Grahev/esp32_targets/hardware/kicad/node.kicad_sch

## KiCad design hardware/kicad/node.kicad_sch (2026-10-24)

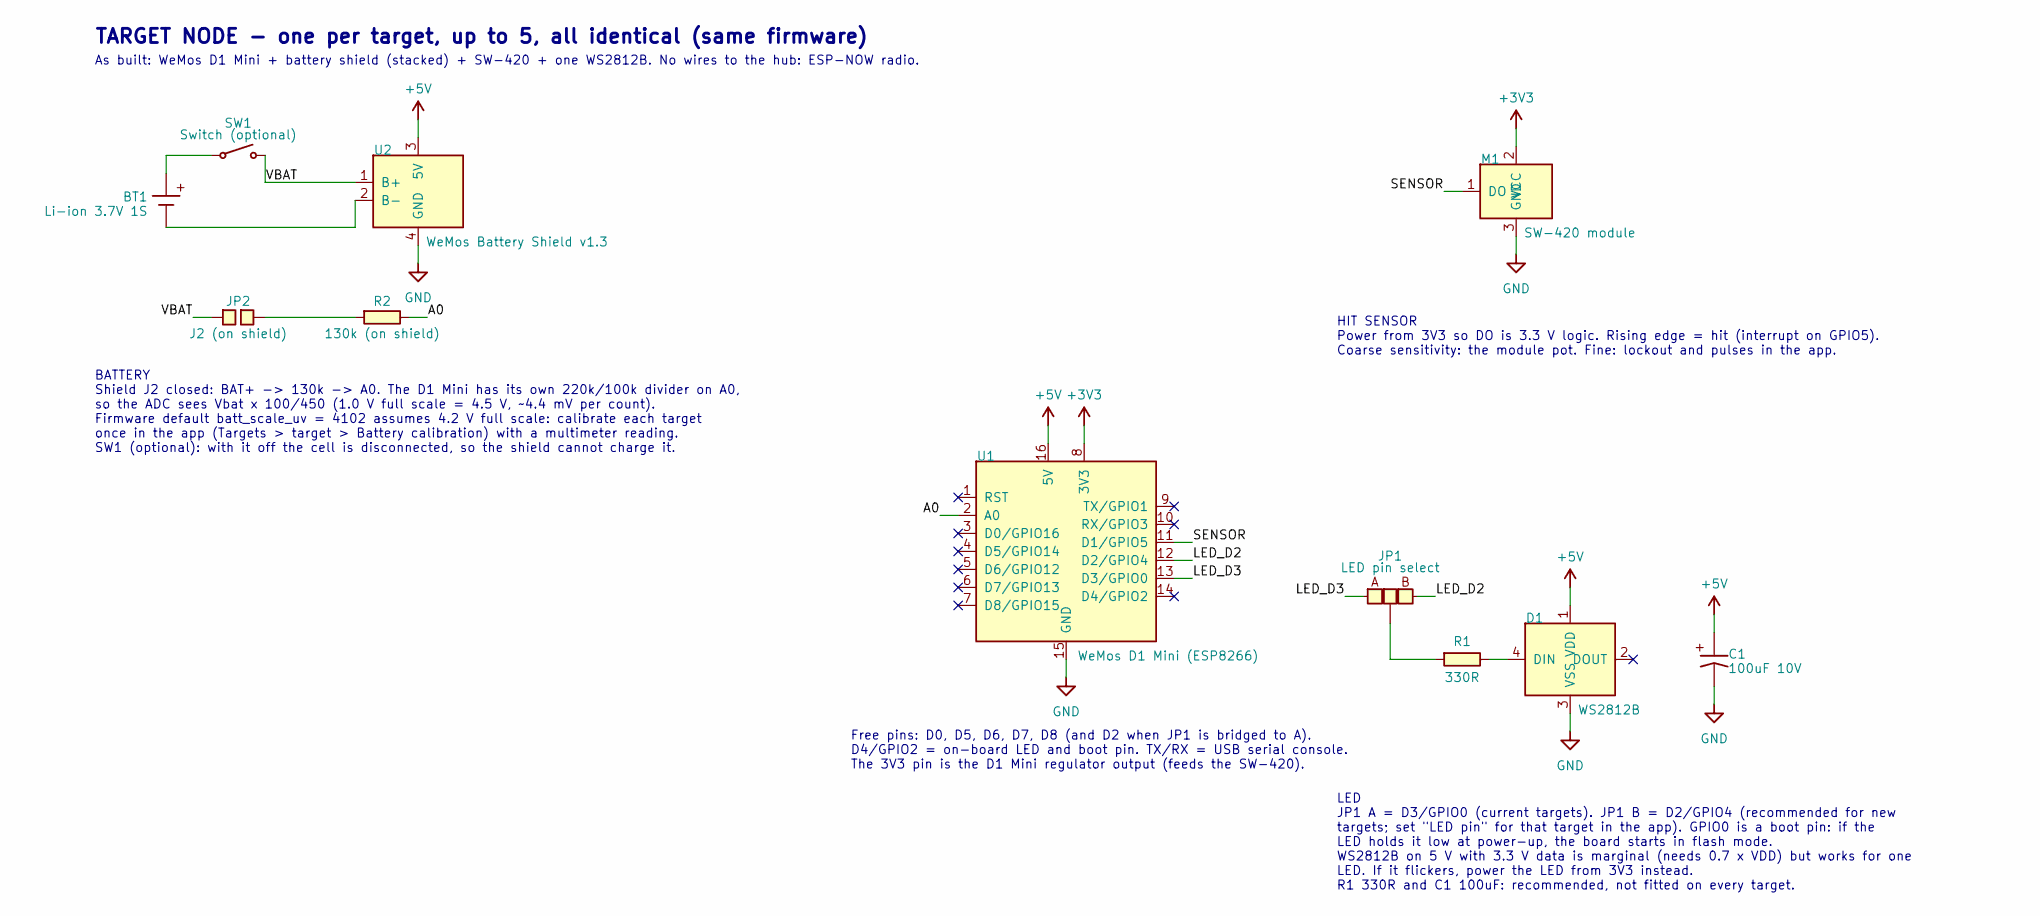
[picture p1: schematic node.kicad_sch]

Parts:
BT1: Li-ion 3.7V 1S
C1: 100uF 10V
D1: WS2812B
JP1: LED pin select
JP2: J2 (on shield)
M1: SW-420 module
R1: 330R
R2: 130k (on shield)
SW1: Switch (optional)
U1: WeMos D1 Mini (ESP8266)
U2: WeMos Battery Shield v1.3

Connections:
+3V3: M1.2 (VCC), U1.8 (3V3)
+5V: C1.1 (+), D1.1 (VDD), U1.16 (5V), U2.3 (5V)
A0: R2.2, U1.2 (A0)
GND: C1.2 (-), D1.3 (VSS), M1.3 (GND), U1.15 (GND), U2.4 (GND)
LED_D2: JP1.3 (B), U1.12 (D2/GPIO4)
LED_D3: JP1.1 (A), U1.13 (D3/GPIO0)
unnamed: BT1.1 (+), SW1.1
unnamed: BT1.2 (-), U2.2 (B-)
unnamed: D1.4 (DIN), R1.2
unnamed: JP1.2 (C), R1.1
unnamed: JP2.2, R2.1
SENSOR: M1.1 (DO), U1.11 (D1/GPIO5)
VBAT: JP2.1, SW1.2, U2.1 (B+)

Notes on the sheet:
TARGET NODE - one per target, up to 5, all identical (same firmware)
As built: WeMos D1 Mini + battery shield (stacked) + SW-420 + one WS2812B. No wires to the hub: ESP-NOW radio.
BATTERY Shield J2 closed: BAT+ -> 130k -> A0. The D1 Mini has its own 220k/100k divider on A0, so the ADC sees Vbat x 100/450 (1.0 V full scale = 4.5 V, ~4.4 mV per count). Firmware default batt_scale_uv = 4102 assumes 4.2 V full scale: calibrate each target once in the app (Targets > target > Batt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
Free pins: D0, D5, D6, D7, D8 (and D2 when JP1 is bridged to A). D4/GPIO2 = on-board LED and boot pin. TX/RX = USB serial console. The 3V3 pin is the D1 Mini regulator output (feeds the SW-420).
HIT SENSOR Power from 3V3 so DO is 3.3 V logic. Rising edge = hit (interrupt on GPIO5). Coarse sensitivity: the module pot. Fine: lockout and pulses in the app.
LED JP1 A = D3/GPIO0 (current targets). JP1 B = D2/GPIO4 (recommended for new targets; set "LED pin" for that target in the app). GPIO0 is a boot pin: if the LED holds it low at power-up, the board starts in flash mode. WS2812B on 5 V with 3.3 V data is marginal (needs 0.7 x VDD) but works for one 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
