Grahev/esp32_targets/(commit log)

2026-01-10 Implement Multi-Node Sensor Support: Protocol update, dynamic hub registration, and automatic node announcement
2026-01-10 Fix Indentation Error in main.py
    [main.py]
2026-01-10 Update Difficulty Curves: Slower respawns, 30s stages, 4s combo timeout
2026-01-30 Add battery monitoring features including percentage and charging status
2026-01-30 Implement node idle behavior: Blue LED indicators and ignore hits when no game is active
2026-10-23 Add CLAUDE.md with project overview and board workflow
    Documents the hub/node ESP-NOW protocol, game flow, and the repo-to-board
    path mapping. Notes that the node is an ESP8266 and fixes the upload
    examples so hub files land at the board root.
2026-10-23 fix: atomic score saves, keep corrupt score files aside (REVIEW #1)
    Scores are written to a .tmp file and renamed over the real file, so a
    power cut can't truncate it. A score file that fails to parse is renamed
    to .corrupt instead of being overwritten by the next save.
    [main.py, storage.py]
2026-10-23 fix: /stop returns nodes to standby then idle (REVIEW #2)
    game_over() takes save=False for aborted games instead of /stop clearing
    hub.game first, which made game_over() a no-op and left nodes Active.
    Adds tools/hub_harness.py to drive the hub's routes on real hardware.
    [hub_harness.py, main.py]
2026-10-23 fix: guard radio listener and game loop, reboot on fatal crash (REVIEW #3)
    - listener drains all pending packets per pass and logs errors instead
    of dying; packet decoding moved to HUB_SYSTEM.handle_packet
    - an exception in tick() aborts the game (nodes to standby) instead of
    silently stopping the game loop task
    - a crash in main() reboots the hub; Ctrl-C still reaches the REPL
    - drops the unreachable 4-field legacy branch and unused Pin import
    [hub_harness.py, main.py]
2026-10-23 fix: reliable multi-node radio protocol and node tracking (REVIEW #4-#10, #18)
    Protocol v2 (hub still accepts v1 packets, so nodes can upgrade one by one):
    - node unicasts to the hub once it knows the hub MAC (ACK + radio retries),
    3 app-level retries, falls back to broadcast (#5)
    - 12-byte little-endian packet with version and sequence number; hub drops
    retried duplicates (#7)
    - hub assigns node IDs by MAC, persisted in nodes.json; nodes store the
    assigned ID via new CMD_SET_ID, no config edits needed (#6)
    Hub:
    - node_registry tracks last_seen; nodes silent for 15 s go offline, are
    removed from the pool and the ESP-NOW peer table, and games are told via
    on_node_lost (#4, #18)
    - c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
    [game_engine.py, hub_harness.py, main.py, node_fake_hit.py, node_registry.py]
2026-10-23 fix: no blocking sleeps in game ticks; Time Attack+ spawn delay and no-repeat (REVIEW #11, #12)
    - The Breach countdown pulses via timed states instead of sleep_ms(100);
    Time Attack+ end no longer sleeps on the event loop (#11)
    - Time Attack+ no longer re-lights the node that was just hit, and waits
    the stage's spawn delay (1.2/0.8/0.5 s) before lighting a new target,
    as the PRD specifies; a single-node setup still gets its node back
    after the delay (#12)
    [game_engine.py]
2026-10-23 fix: The Breach precision bonus no longer compounds (REVIEW #13)
    The 1.2x bonus is applied to the level's points instead of the running
    total. A failed game now ends exactly once.
    Adds tests/sim.py (fake clock + fake hub with N nodes) and
    tests/test_game_modes.py: 14 multi-node scenarios for both modes, e.g.
    10-node spawn fairness, nodes joining/leaving mid-game, spawn delay,
    no-repeat, freeze, bonus compounding.
    [game_engine.py, hub_harness.py]
2026-10-23 fix: time out WebSocket sends and drop stuck clients (REVIEW #14)
    Each send runs under a 2 s timeout; a client whose send fails is removed
    and its socket closed, instead of piling up blocked send tasks. Initial
    state sends are inside the handler's try so a failed client is always
    removed.
    Also: a MEM log line every 60 s (python + IDF heap), new review finding
    #36 (low IDF heap headroom), PC hub tests (tests/test_hub.py with stubbed
    MicroPython modules) and harness scenarios for The Breach, crash
    injection and an on-device HTTP/WebSocket client.
    [hub_harness.py, main.py]
2026-10-23 fix: validate /start, report refusals in the dashboard (REVIEW #15)
    - /start checks mode, duration, delay and difficulty and returns 400 with
    a reason, or 409 when no nodes are online
    - starting while a game runs ends the old game cleanly first
    - /stop says when no game is running
    - the dashboard logs the hub's reason when a command is refused, and dims
    nodes reported offline in the battery table
    Verified on the hub with an on-device HTTP/WebSocket client.
    [hub_harness.py, main.py]
2026-10-24 perf: recover ~59 KB of hub memory for WiFi (REVIEW #36)
    The hub's 56 KB initial Python heap was full after boot (Microdot alone
    ~23 KB of RAM), so MicroPython doubled it out of the IDF heap, leaving
    WiFi/sockets/ESP-NOW ~37 KB. Now idf_free is ~96 KB at boot and stays
    87-96 KB in an on-hub load test (2 WebSocket clients, page loads, game).
    - hub/webserver.py: small HTTP + WebSocket server replaces Microdot
    - hub modules deployed as precompiled .mpy (tools/build_hub.sh);
    hub/main.py -> hub/hub_app.py, main.py is a 3-line stub
    - game modes split into mode_time_attack.py / mode_breach.py, loaded on
    first use
    - leaderboards streamed from file into HTTP/WebSocket replies
    - game freed before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
    [fake_nodes.py, game_engine.py, hub_app.py, hub_harness.py, main.py, mode_breach.py, mode_time_attack.py]
2026-10-24 feat(v2): shared protocol v3 and ESP8266 node firmware
    - firmware/shared: protocol.h (one definition for hub, node and tests), version.h
    - firmware/node: C++/Arduino node. Channel search, pairing, unicast with
    retries, heartbeats answered by the hub, node-side LED effects, reaction
    time measured on the node, configurable hit filter, battery curve, OTA
    receiver (MD5 checked), serial console for testing
    - 18 host tests (pio test -e native); ESP8266 build: 41% RAM, 32% flash
    Claude-Session: https://claude.ai/code/session_01PQGeLdGzjUFwSX352YjcJP
2026-10-24 wip(v2): hub core (pairing, liveness, game modes, records, virtual targets, node OTA)
    Host tests: 23 pass, 3 fail (score rank off by one, Shoot/No-Shoot 'held'
    count, reaction-time test timing). ESP32 glue, web app and docs not
    written yet.
    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
    [partitions.csv]
2026-10-24 fix(v2): Shoot/No-Shoot never showed hostages with one lit target; test fixes
    - A lone target may now be a hostage; with several lit, one is always a threat
    - Tests: tie ranks after the older score; reaction-time test waits for red
    - serial_log.py --send=CMD drives the v2 node console
    - v2 node firmware flashed and verified on the real D1 Mini (boots, searches
    channels, console hit registers); v1 boards backed up first
    Hub host tests: 26/26 pass.
    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
    [serial_log.py]
2026-10-24 feat(v2): ESP32 hub firmware; first hardware link with the real node
    - src/: ESP-NOW radio, LittleFS store, WebSocket events, HTTP API, captive
    portal, backup/restore (one part at a time), hub and node OTA, safe mode
    after 3 crashes, loop watchdog, status line with radio counters
    - Partitions: 2 x 1.5 MB app (first build was 92% of 1.25 MB), 896 KB LittleFS
    - Fix: hub answered heartbeats with a node->hub message type, so nodes
    dropped the answers and re-paired every ~8 s. New HubAck (0x8C); tests
    for link stability (node 19/19, hub 27/27)
    - Fix: LittleFS partition label
    - Hardware: hub boots with 185 KB heap free; node pairs and stays linked
    - web/: app scaffold, data layer and embed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
    [partitions.csv]
2026-10-24 feat(v2): hub serial console (state/start/stop/set/sensor), hits logged
    First real games on hardware (hub + D1 Mini node, hits via the node
    console): Free Practice 5/5 hits, Time Attack+ 10/10 hits scored, combo
    x1.5 from the 4th hit, node-measured reaction time 293-299 ms against an
    expected 300 ms.
    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
2026-10-24 feat(v2): mobile web app, embedded in the hub firmware
    Preact + signals + TypeScript, 22.6 KB gzipped (budget 60 KB):
    - Play: player picker, mode cards, setup sheet generated from each mode's
    schema (presets, steppers, toggles), rules, online-target check,
    low-battery confirmation
    - Live HUD: big timer/score, LED-mirroring target tiles (simulated ones
    tappable), hit feed, hold-to-stop, countdown, beeps + vibration, screen
    kept awake where the browser allows
    - Results: rank, stats, reaction time per target with the slowest marked
    - Targets: add/ignore new targets, tap-to-identify, per-target sheet
    (name, number swap, sensor tuning, battery calibration, blink, restart,
    remove), liv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
2026-10-24 docs(hardware): KiCad schematic of the hub and target node, as built
    hardware/kicad/ holds a KiCad 6 project (opens in 6-9) with a root
    overview, the target node (D1 Mini + battery shield, SW-420, WS2812B,
    LED pin jumper) and the hub (ESP32 DevKit). It is generated by
    hardware/tools/gen_schematic.py, which checks every pin and net before
    writing, together with an SVG preview. hardware/README.md has the BOM,
    the header wiring table and the battery calibration note (with shield
    J2 closed, A0 full scale is 4.5 V, not the 4.2 V the default assumes).
    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
    [esp32_targets.kicad_sch, hub.kicad_sch, node.kicad_sch]
